Taur-Tech/Project-Ryu---Loudspeaker-Drivers/README.md

# Project-Ryu---Loudspeaker-Drivers
Design files for field coil loudspeaker drivers
