Taur-Tech/Project-Ryu---Loudspeaker-Drivers/Spreadsheets/Voice Coil Design.xlsx

Sheet: ECCAW
Wire Diameter: |  |  | 0.13 | mm |  |  |  | Cone Mass |  | 1
Density: |  |  | 3.7 | g/cm^3
Resistivity: |  |  | 0.0255 | ohm mm^2/m |  |  |  | VC Radius: | 25 | mm
Flux Density [B]: |  |  | 1.5 | T |  |  |  | Circ: | 157.0796327 | mm
Cross-sectional Area: |  |  | 0.000132665 | cm^2
 |  |  |  |  |  |  |  |  |  |  |  |  |  |  |  |  |  |  | 6mm Hvc
L wire | Mass | BL | DCR | VC h mm | Turns | DCR || | Mass || | noS/no|| |  |  |  |  |  |  |  | Zn | Len Wire | Rdc | Obs | BL | Mvc | BL^2/Rdc
1 | 0.05 | 1.5 | 1.92 | 0.8276057041 | 6.366197724 | 0.96 | 0.10 | 0.5233946729 |  | 0.5233946729 | 0.5080493055 | 0.5040573113 | 0.5027122104 | 0.5020369201 | 0.5016308648 | 16 | 7.33 | 14.09 | Single layer | 10.995 | 0.36 | 8.580303971
2 | 0.10 | 3 | 3.84 | 1.655211408 | 12.73239545 | 1.92 | 0.20 | 0.5446979576 |  | 0.5446979576 | 0.5158435518 | 0.5080493055 | 0.5053951551 | 0.5040573113 | 0.5032511253 | 8 | 7.33 | 7.04 | 2 Layer Parallel | 10.995 | 0.72 | 17.16060794
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
