Taur-Tech/Project-Ryu---Loudspeaker-Drivers/Drivers/F144/common/F144_driver_drawing.dxf

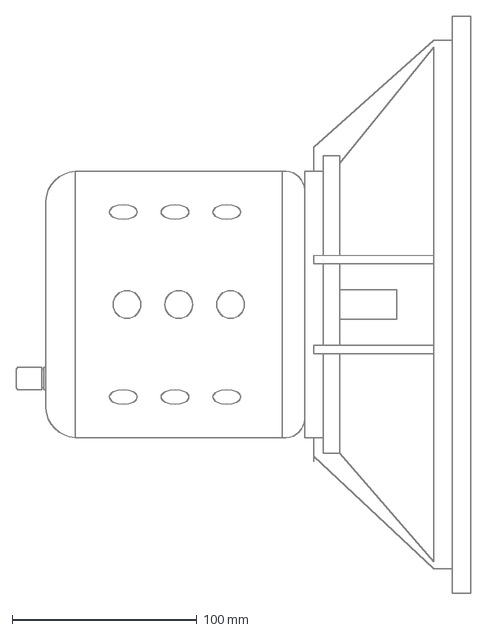
[picture p1: CAD file, 2017-06-22]
Drivers/F144/common/F144_driver_drawing.dxf
246.0 x 312.0 mm
