Taur-Tech/Project-Ryu---Loudspeaker-Drivers/Drivers/F144/motor/3D/step/F144_CP.step

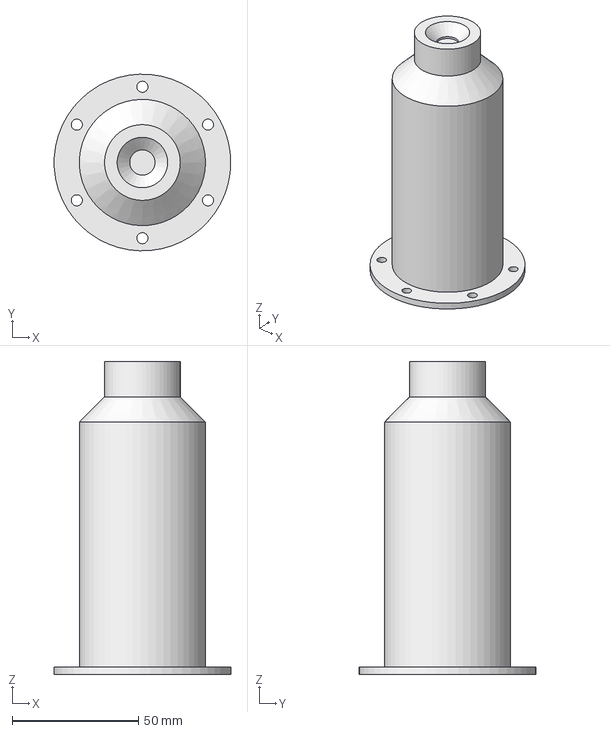
[picture p2: CAD file, 2017-01-30]
Drivers/F144/motor/3D/step/F144_CP.step
69.9 x 70.0 x 124.0 mm
