Taur-Tech/Project-Ryu---Loudspeaker-Drivers/Drivers/F144/motor/3D/stl/F144_FR2.stl

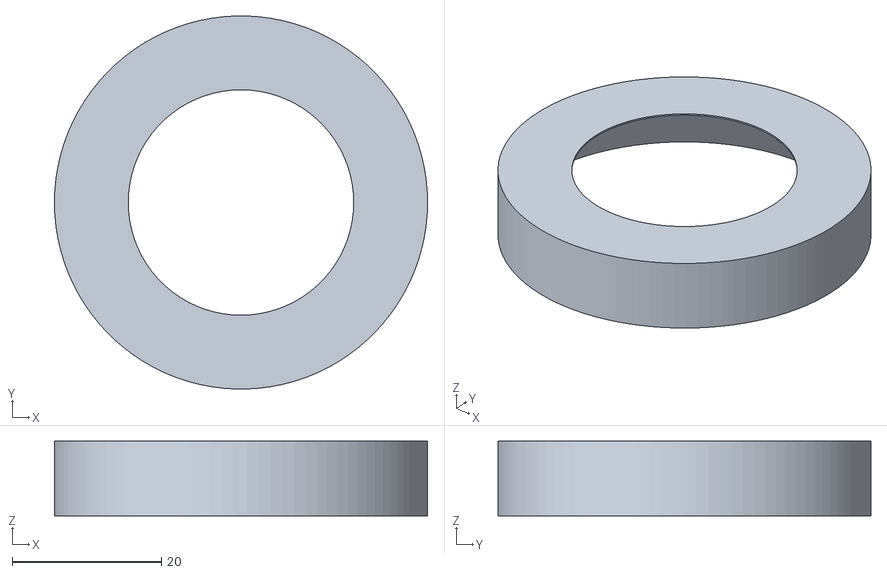
[picture p3: CAD file, 2017-05-06]
Drivers/F144/motor/3D/stl/F144_FR2.stl
50.0 x 50.0 x 10.0
