Taur-Tech/Project-Ryu---Loudspeaker-Drivers/Drivers/F144/motor/3D/step/F144_BP.step

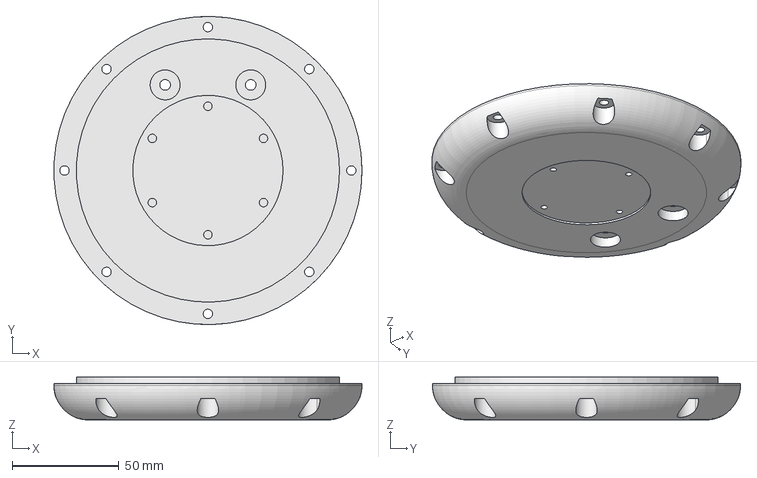
[picture p4: CAD file, 2017-01-30]
Drivers/F144/motor/3D/step/F144_BP.step
143.9 x 143.9 x 20.0 mm
