Taur-Tech/Project-Ryu---Loudspeaker-Drivers/Drivers/F144/motor/3D/step/F144_TP.step

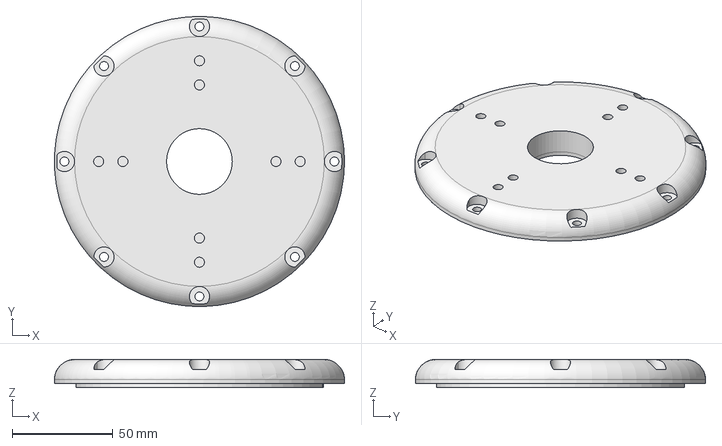
[picture p5: CAD file, 2017-01-30]
Drivers/F144/motor/3D/step/F144_TP.step
143.9 x 143.9 x 14.0 mm
