Taur-Tech/Project-Ryu---Loudspeaker-Drivers/(list of files, cad)

Other CAD files:
Drivers/F144/motor/3D/igs/F144_BP.iges
Drivers/F144/motor/3D/igs/F144_CP.iges
Drivers/F144/motor/3D/igs/F144_TP.iges
