Taur-Tech/Project-Ryu---Loudspeaker-Drivers/Drivers/F124/Project Ryu F124.pdf

1 | 2 | 3 | 4 | 5 | 6 | 7 | 8

64.00 mm

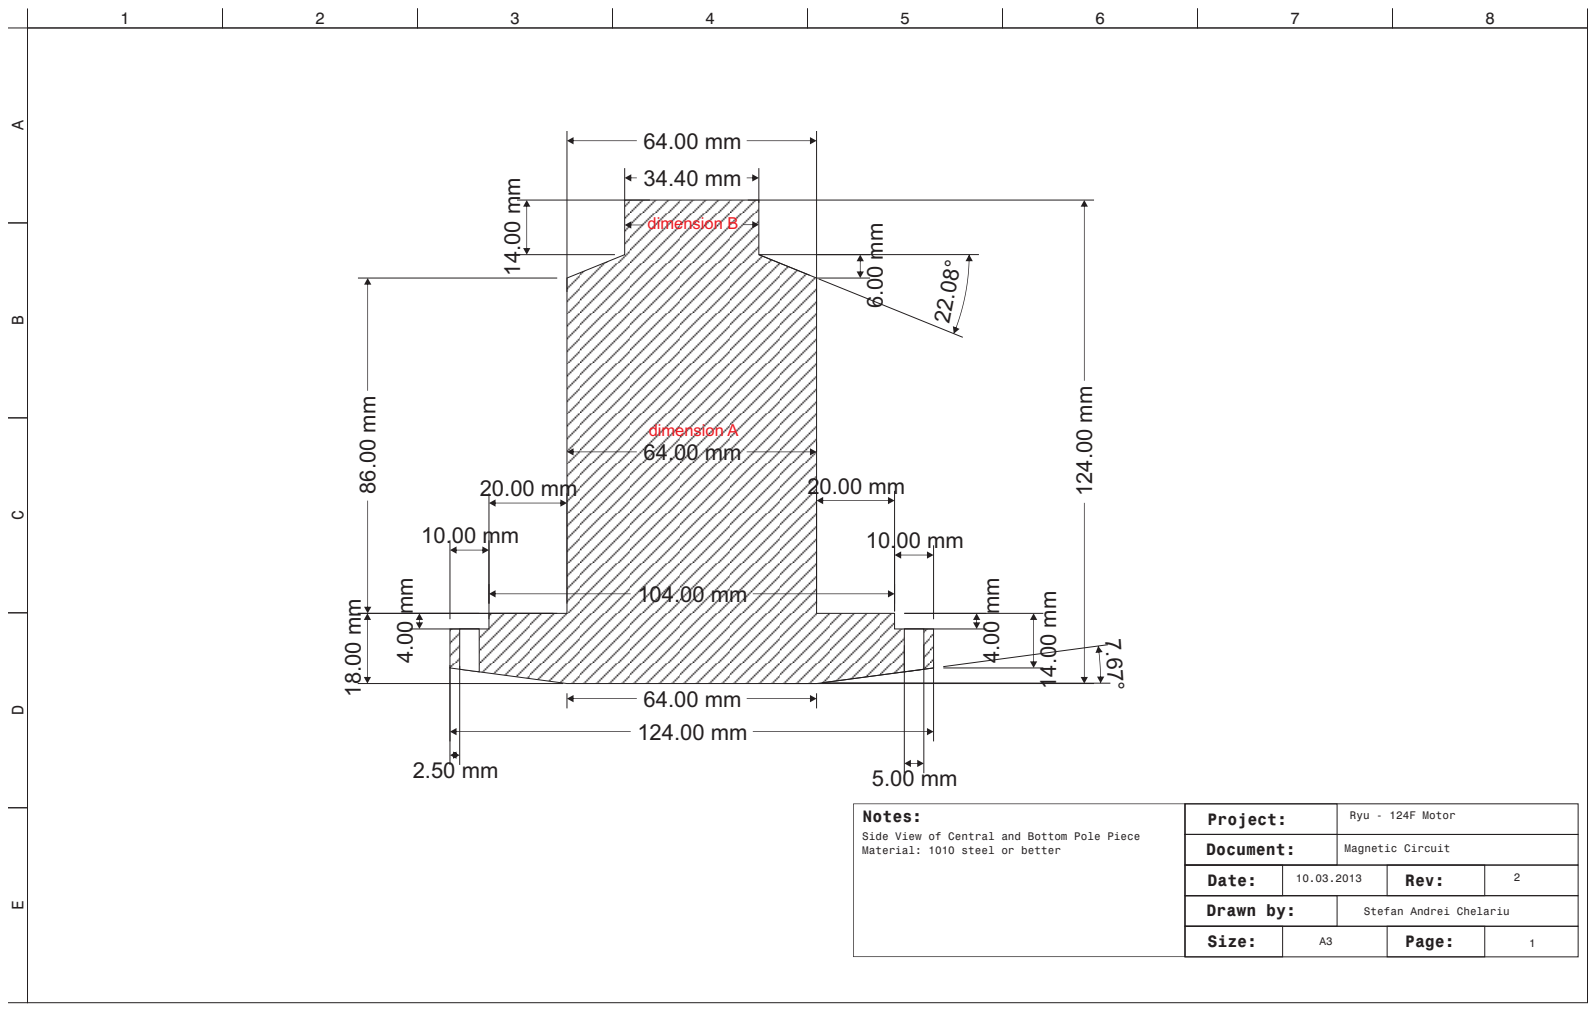
[picture p9: page 1]
Project:; Document:; Date:; Rev:; Drawn by:; Size:; Page:; Ryu - 124F Motor; Magnetic Circuit; Notes:; dimension A; dimension B

Side View of Central and Bottom Pole Piece
Material: 1010 steel or better

Stefan Andrei Chelariu

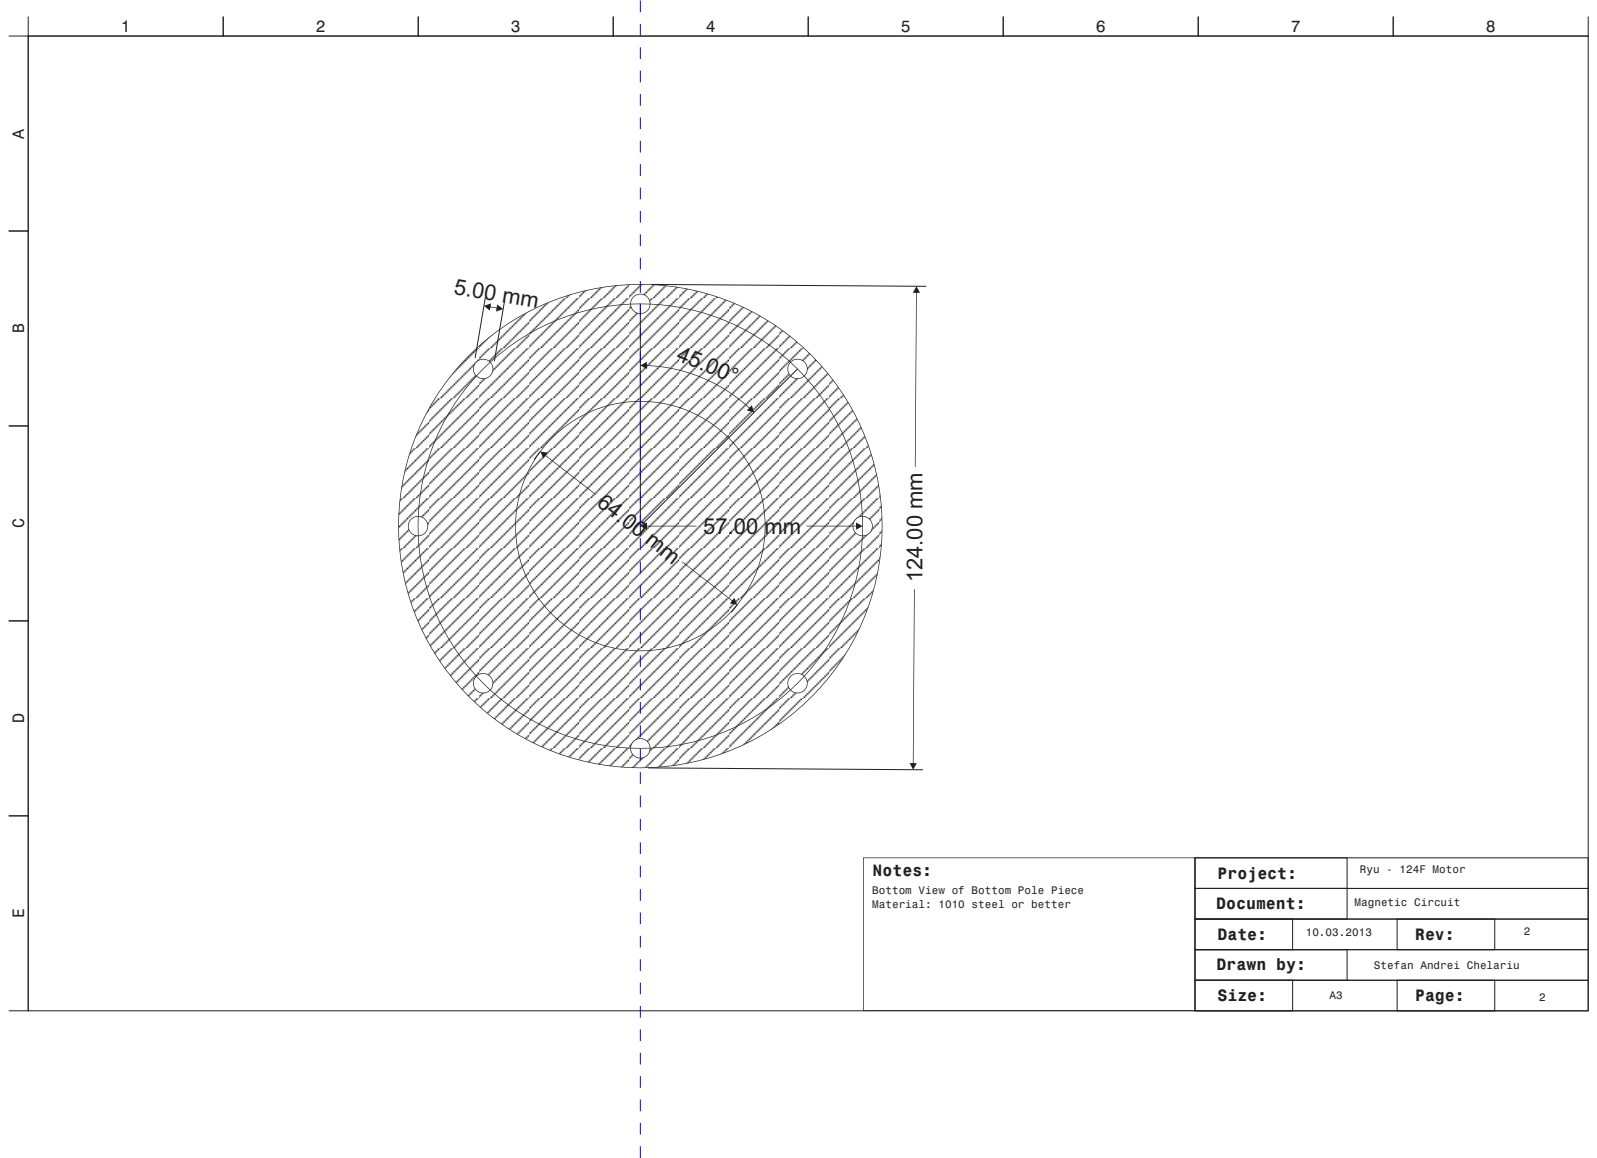
[picture p10: page 2]
Notes:

Project: | Ryu - 124F Motor

Bottom View of Bottom Pole Piece
Material: 1010 steel or better

Document: | Magnetic Circuit
Date: | 10.03.2013 | Rev: | 2
Drawn by: | Stefan Andrei Chelariu
Size: | A3 | Page: | 2

124.00 mm

37.40 mm

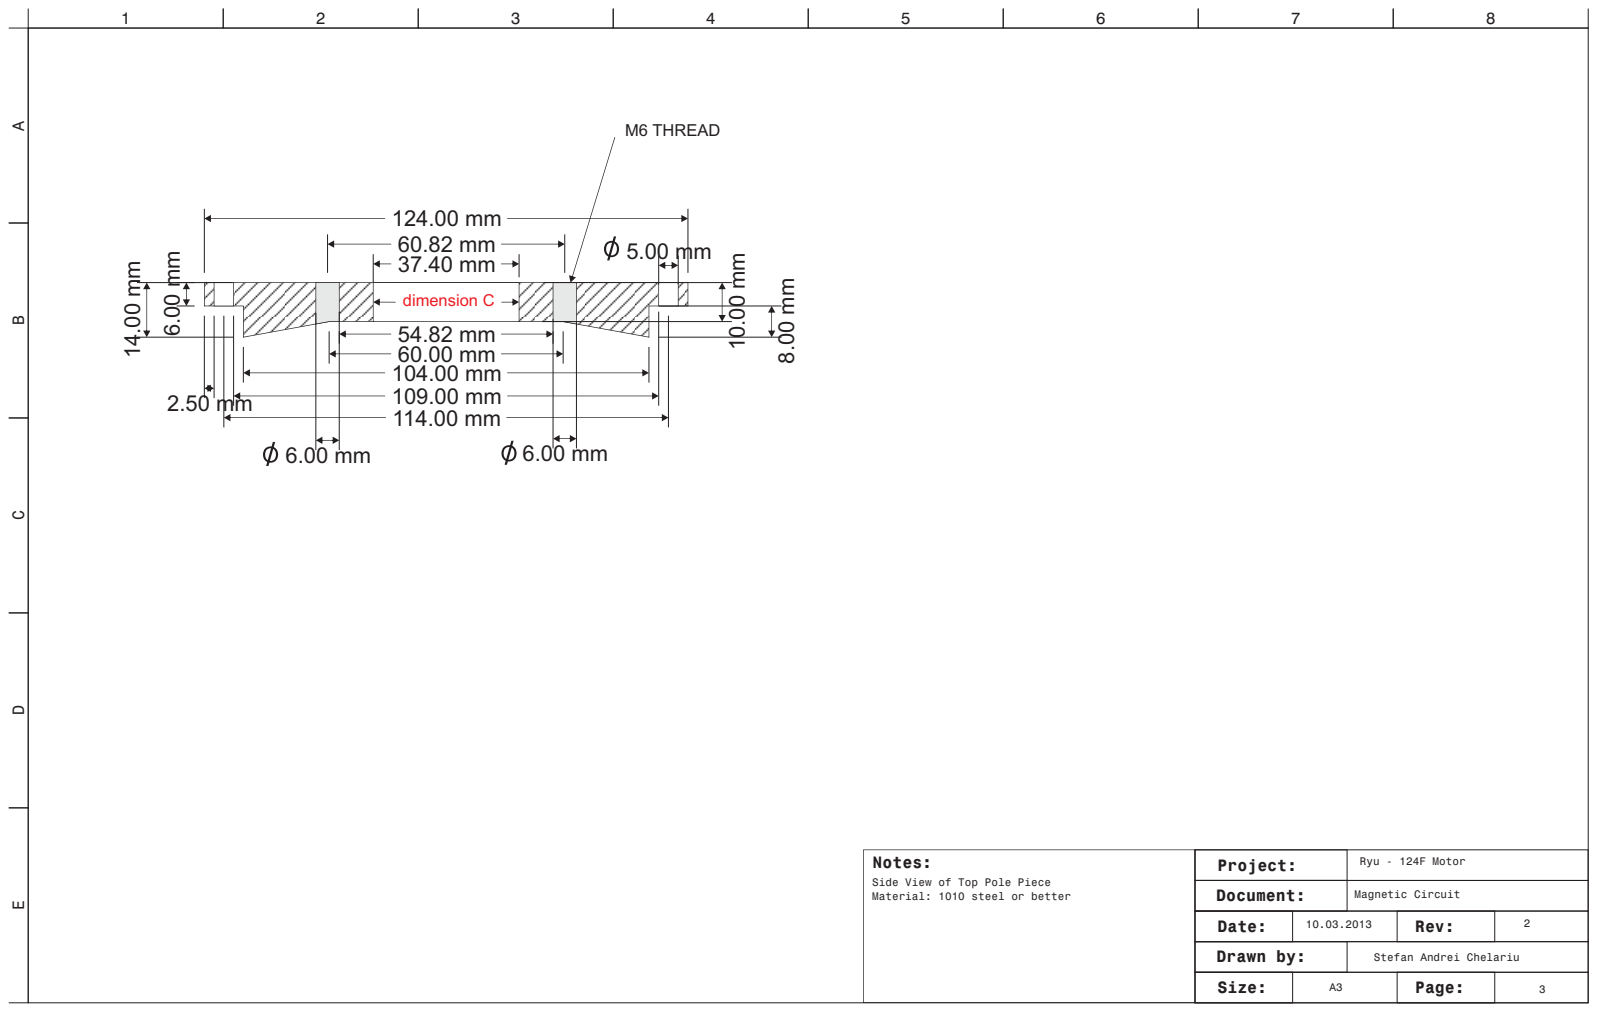
[picture p11: page 3]
Project:; Document:; Date:; Rev:; Drawn by:; Size:; Page:; Ryu - 124F Motor; Magnetic Circuit; Notes:; dimension C; M6 THREAD

Side View of Top Pole Piece
Material: 1010 steel or better

Stefan Andrei Chelariu

5.00 mm | 5.00 mm

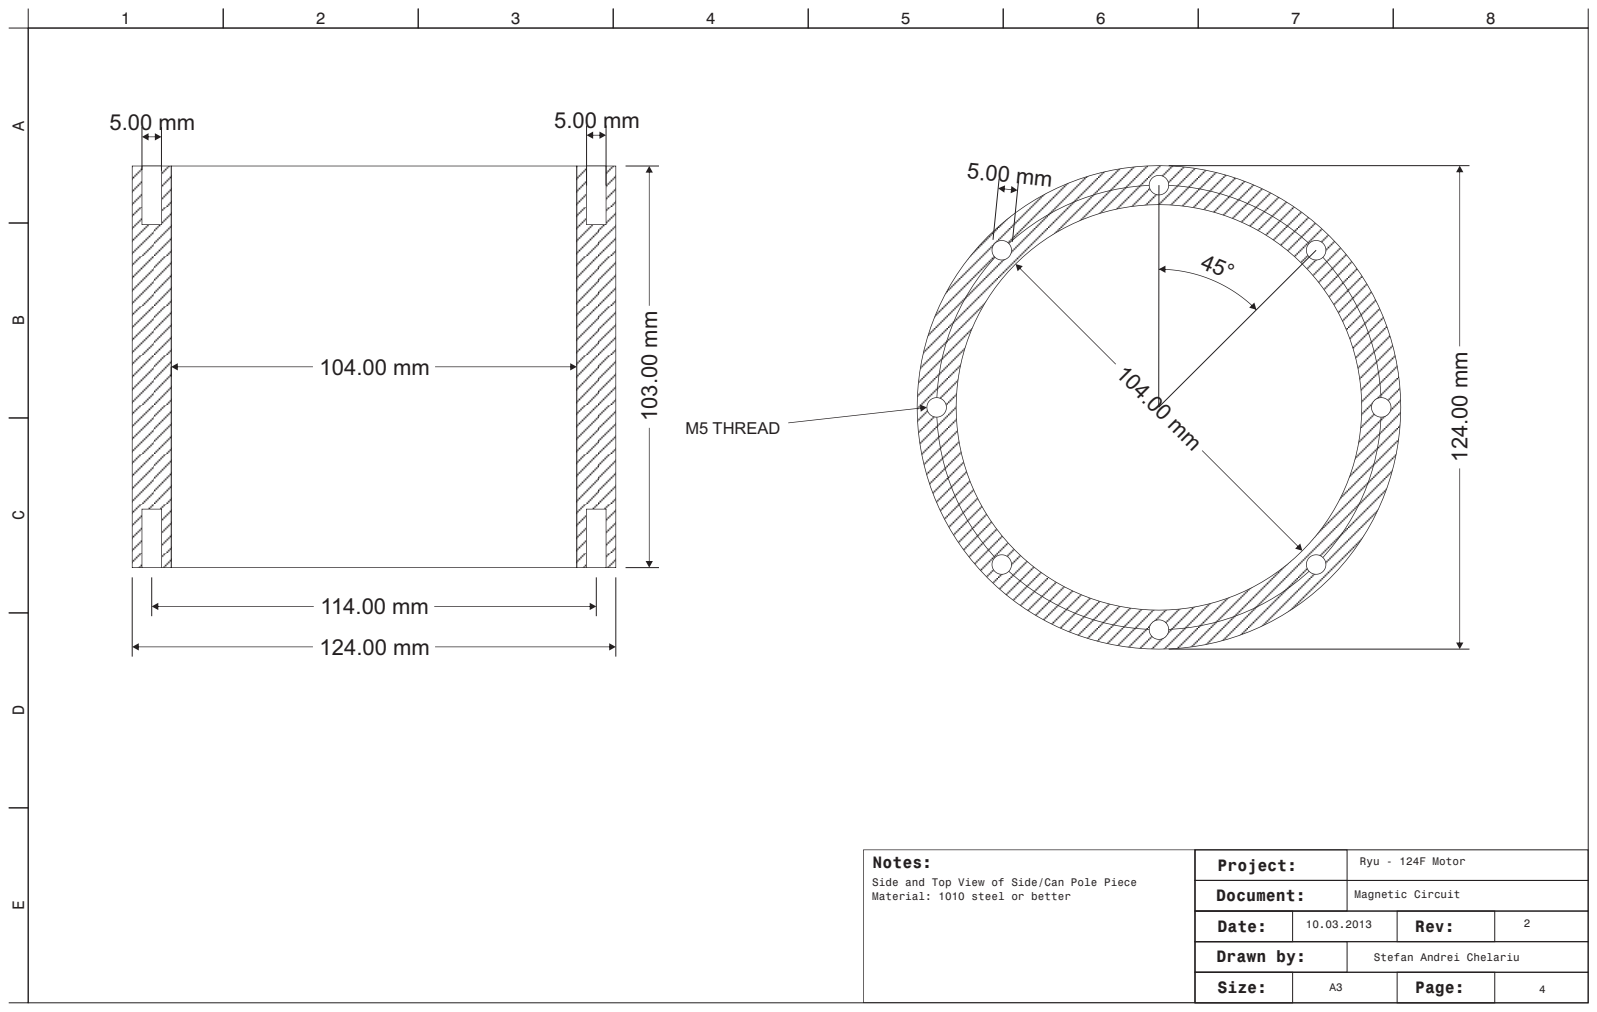
[picture p12: page 4]
Project:; Document:; Date:; Rev:; Drawn by:; Size:; Page:; Ryu - 124F Motor; Magnetic Circuit; Notes:; M5 THREAD

Side and Top View of Side/Can Pole Piece
Material: 1010 steel or better

Stefan Andrei Chelariu

5.00 mm

## M6 THREAD

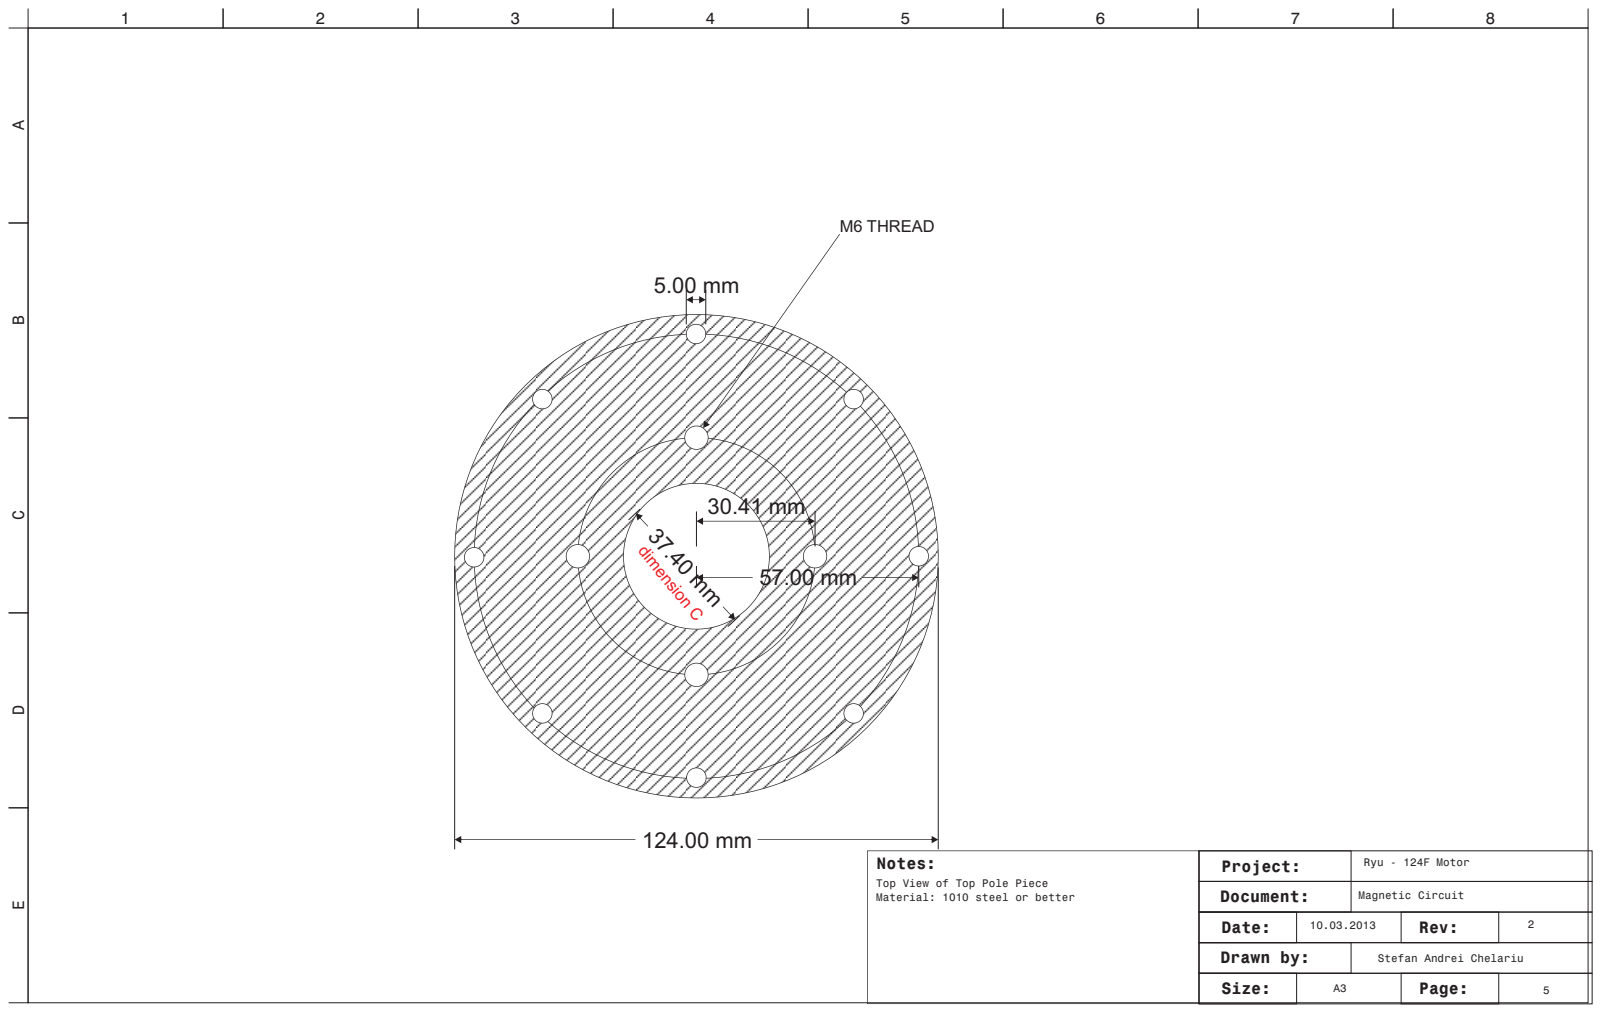
[picture p13: page 5]
Notes:; dimension C

Project: | Ryu - 124F Motor

Top View of Top Pole Piece
Material: 1010 steel or better

Document: | Magnetic Circuit
Date: | 10.03.2013 | Rev: | 2
Drawn by: | Stefan Andrei Chelariu
Size: | A3 | Page: | 5
