Taur-Tech/Project-Ryu---Loudspeaker-Drivers/Drivers/F160/Project Ryu F160 Drawing.pdf

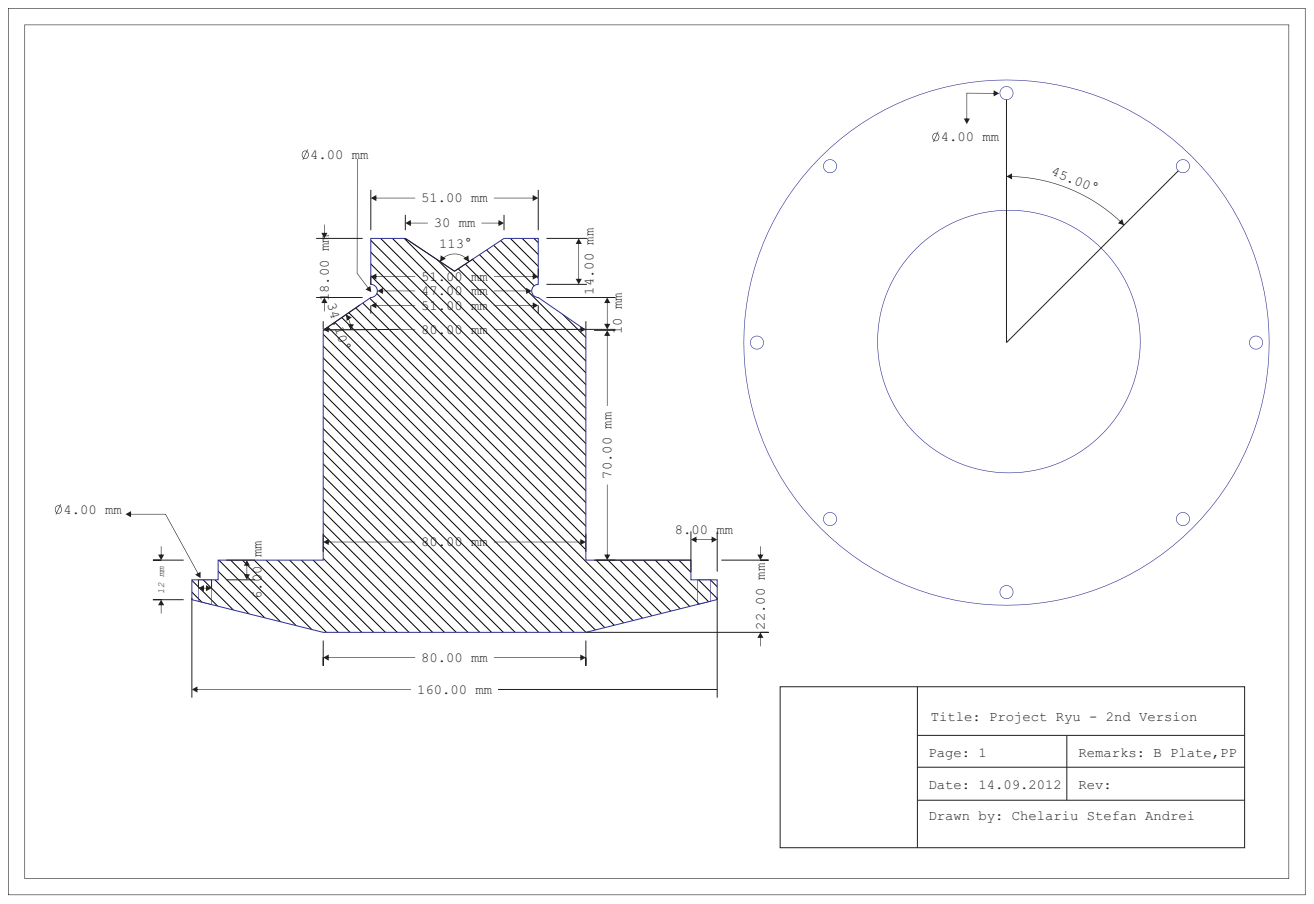
[picture p14: page 1]
Page: 1; Remarks: B Plate,PP; Date: 14.09.2012; Rev:

Title: Project Ryu - 2nd Version

Drawn by: Chelariu Stefan Andrei

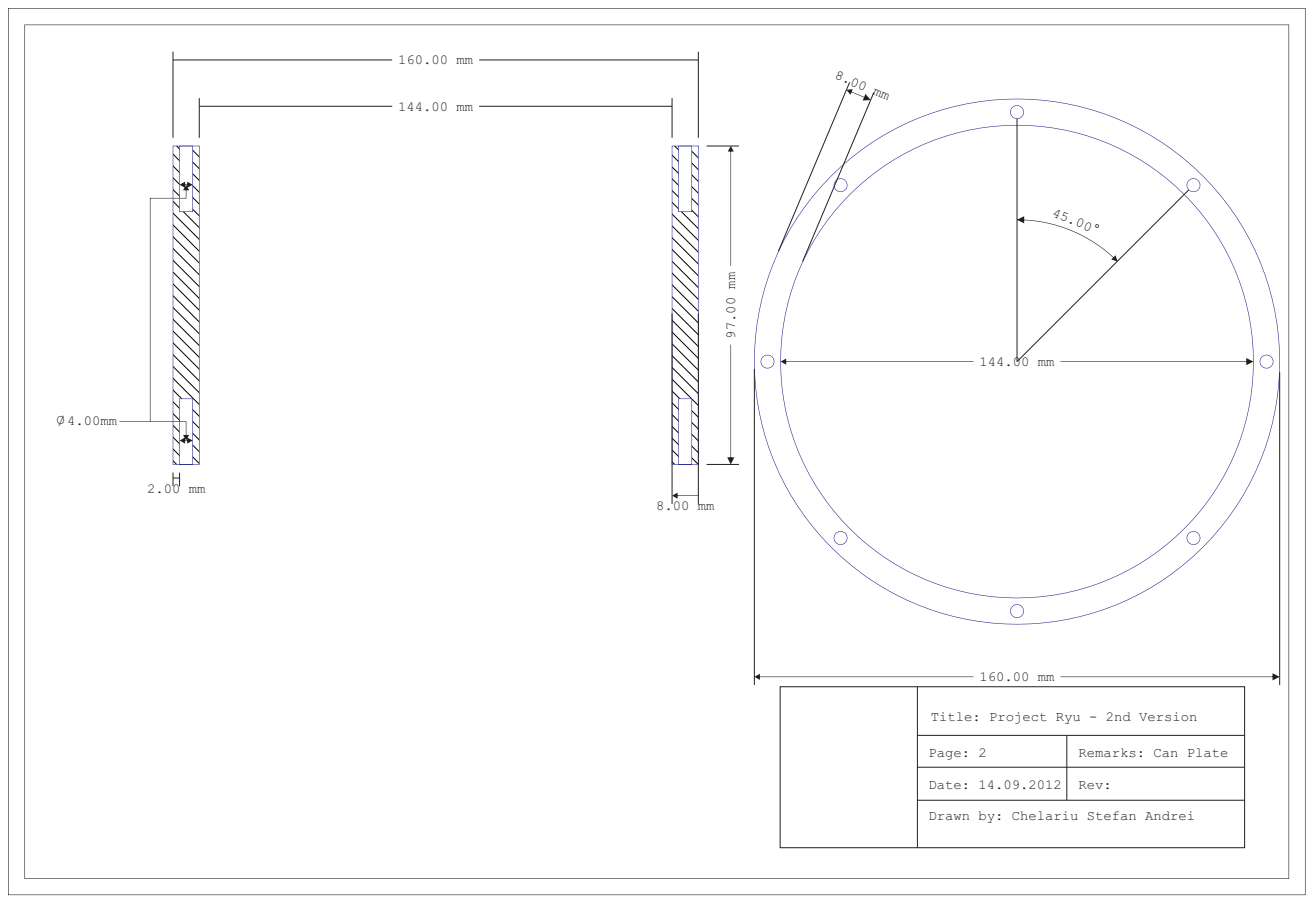
[picture p15: page 2]
Page: 2; Remarks: Can Plate; Date: 14.09.2012; Rev:

Title: Project Ryu - 2nd Version

Drawn by: Chelariu Stefan Andrei

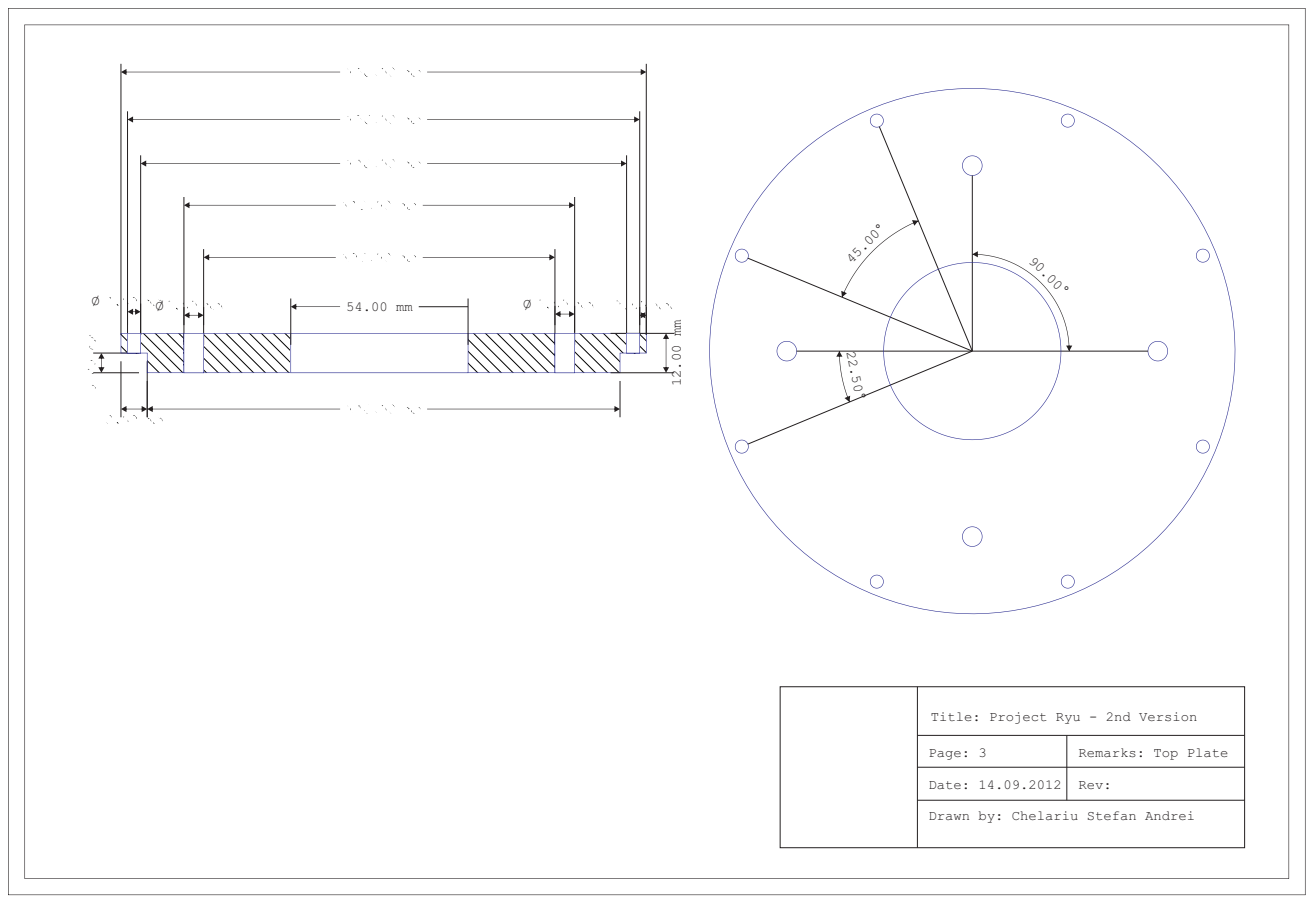
[picture p16: page 3]
Page: 3; Remarks: Top Plate; Date: 14.09.2012; Rev:

Title: Project Ryu - 2nd Version

Drawn by: Chelariu Stefan Andrei
