Taur-Tech/Project-Ryu---Loudspeaker-Drivers/Drivers/F144/motor/2D/F144_FR2.pdf

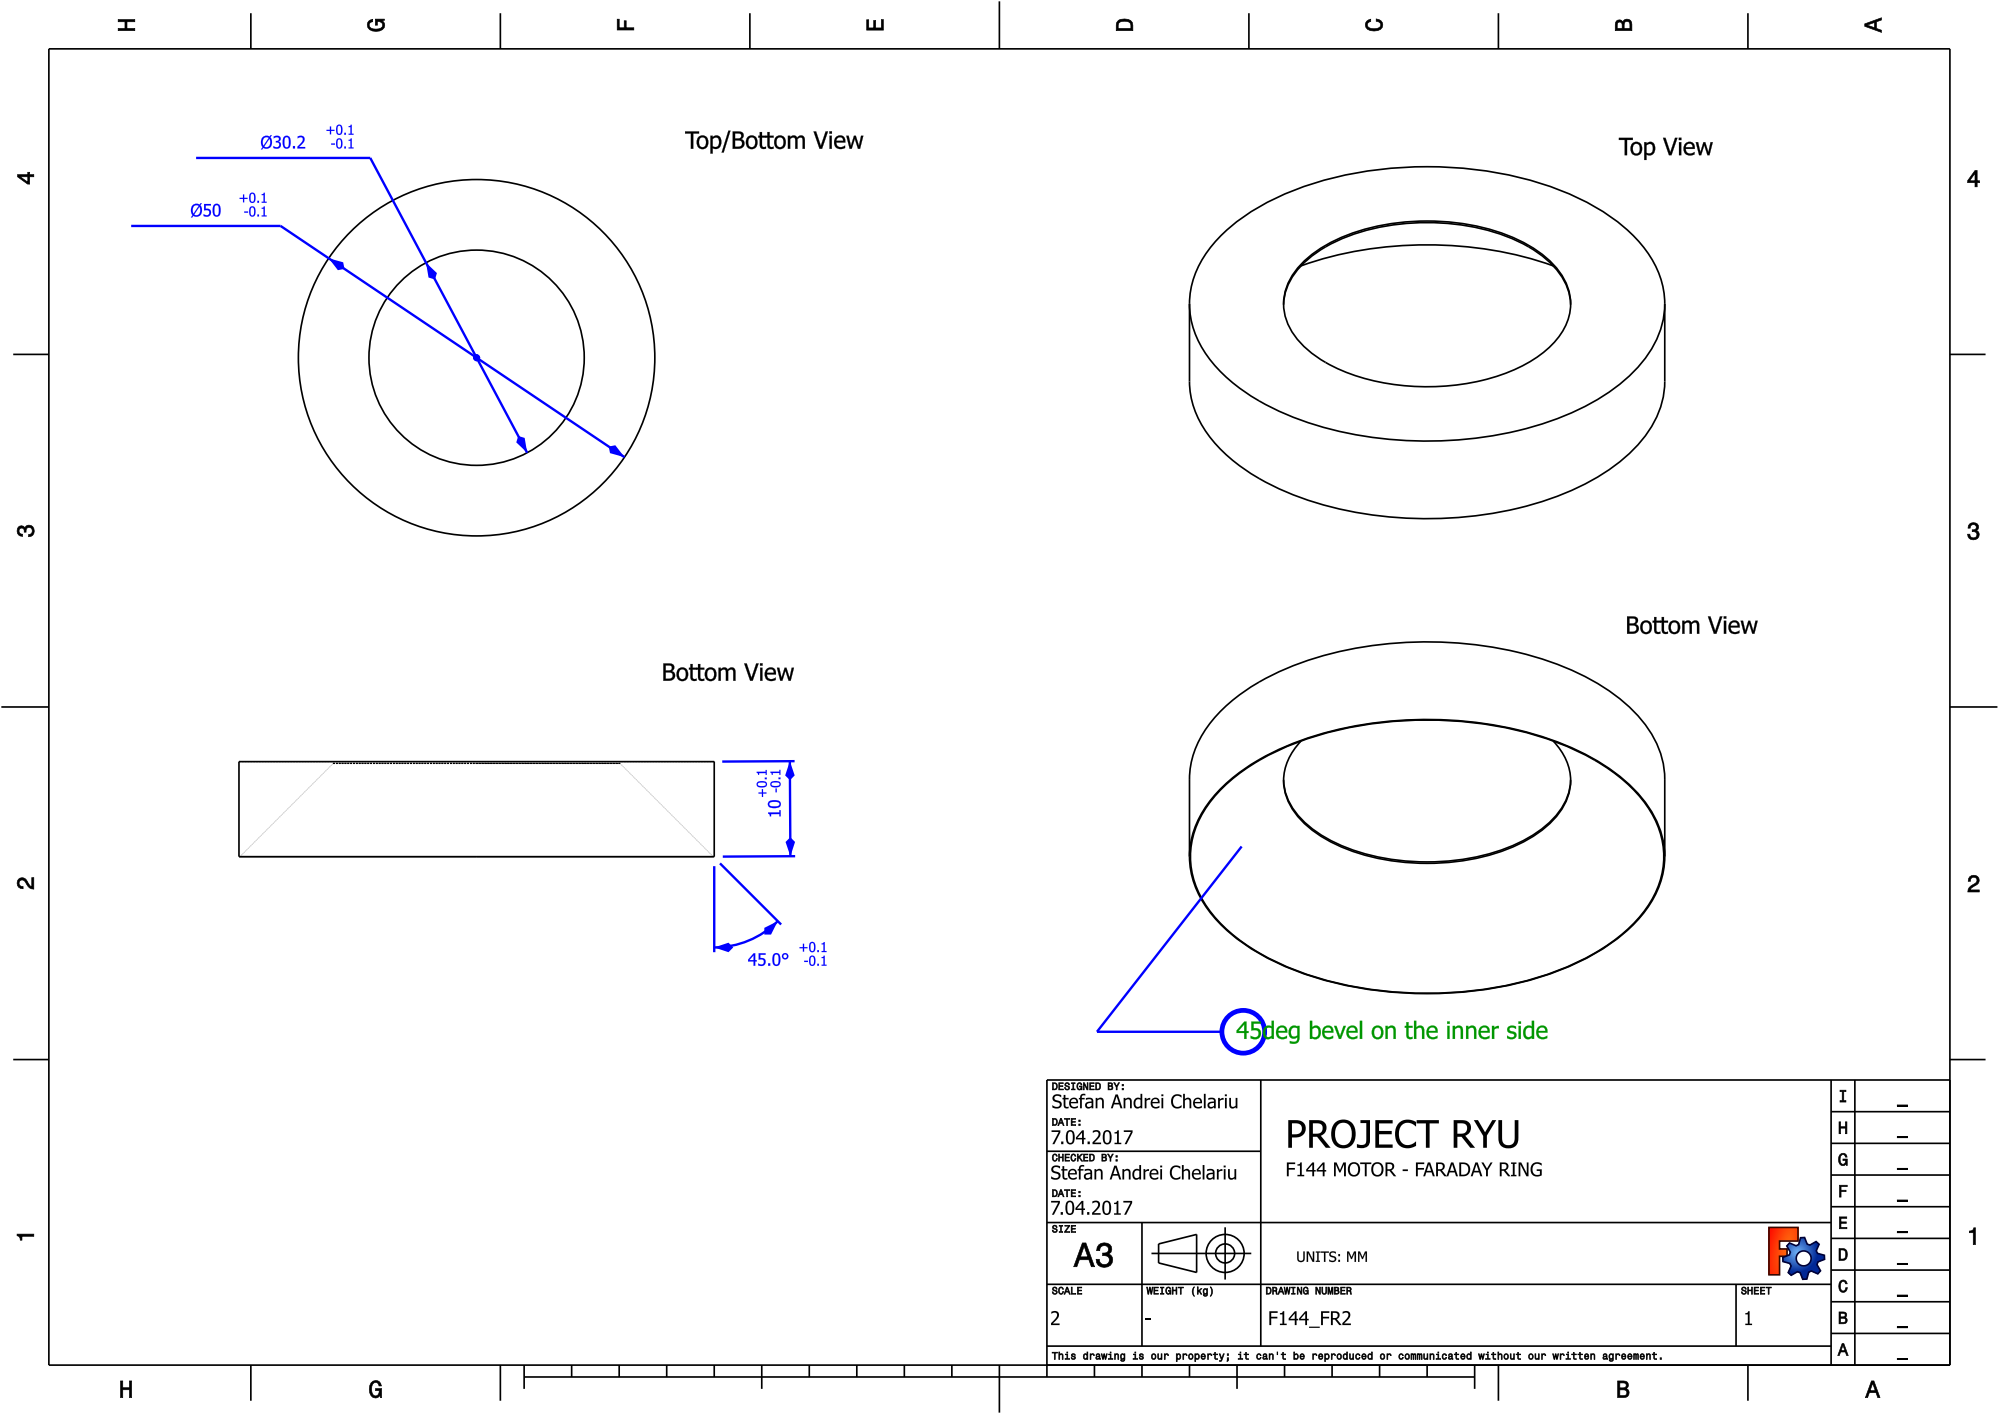
[picture p17: page 1]
