Taur-Tech/Project-Ryu---Loudspeaker-Drivers/Drivers/F144/motor/2D/F144_BP.pdf

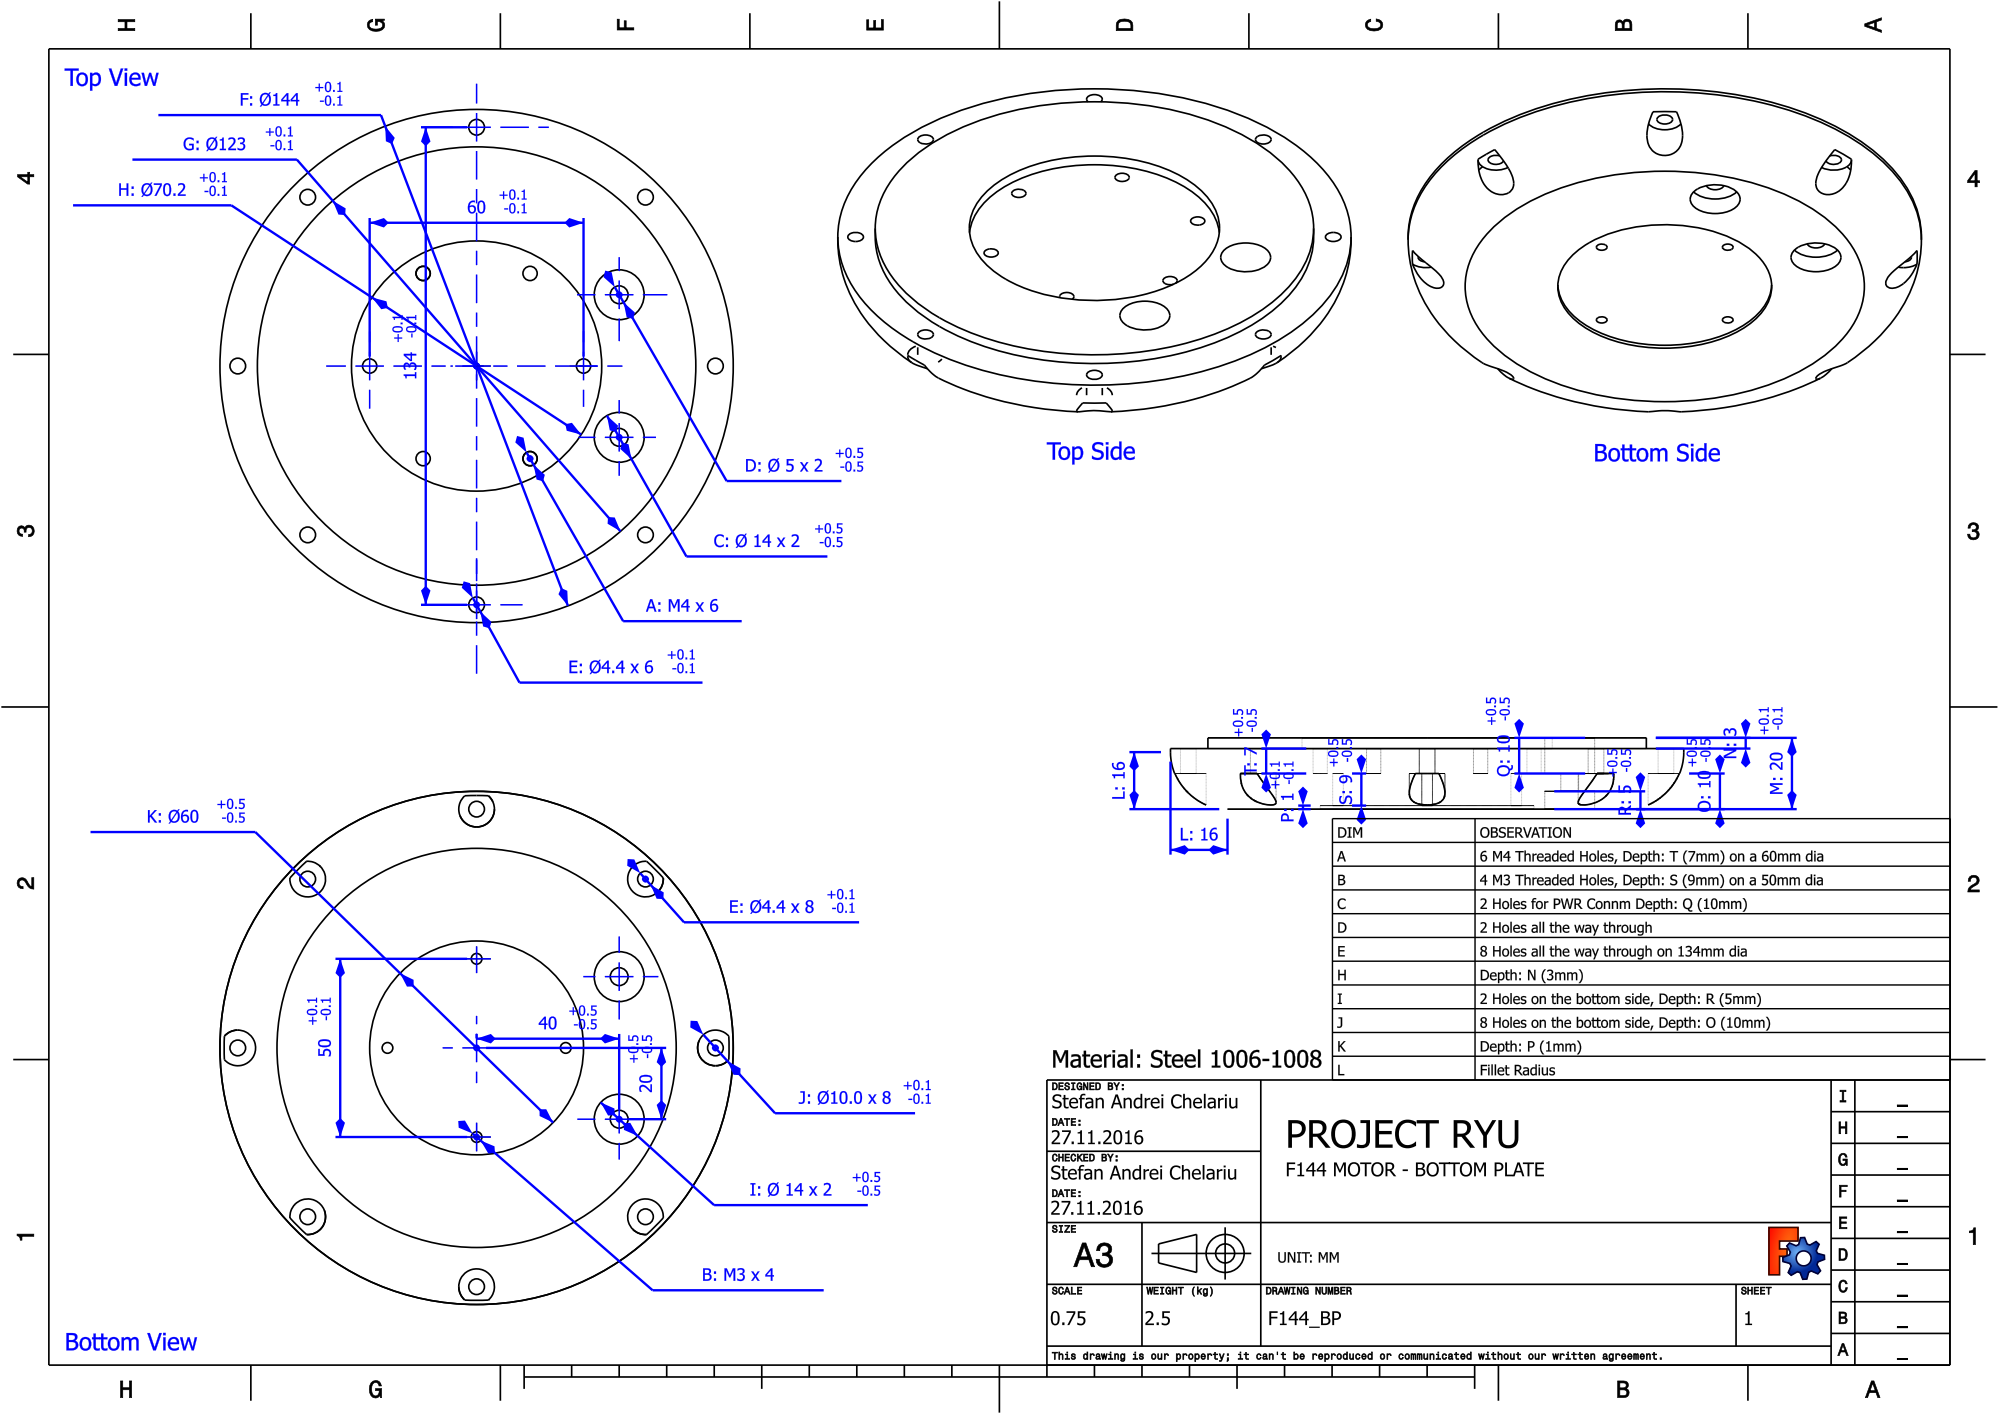
[picture p18: page 1]
