Taur-Tech/Project-Ryu---Loudspeaker-Drivers/Drivers/F144/motor/2D/F144_CP.pdf

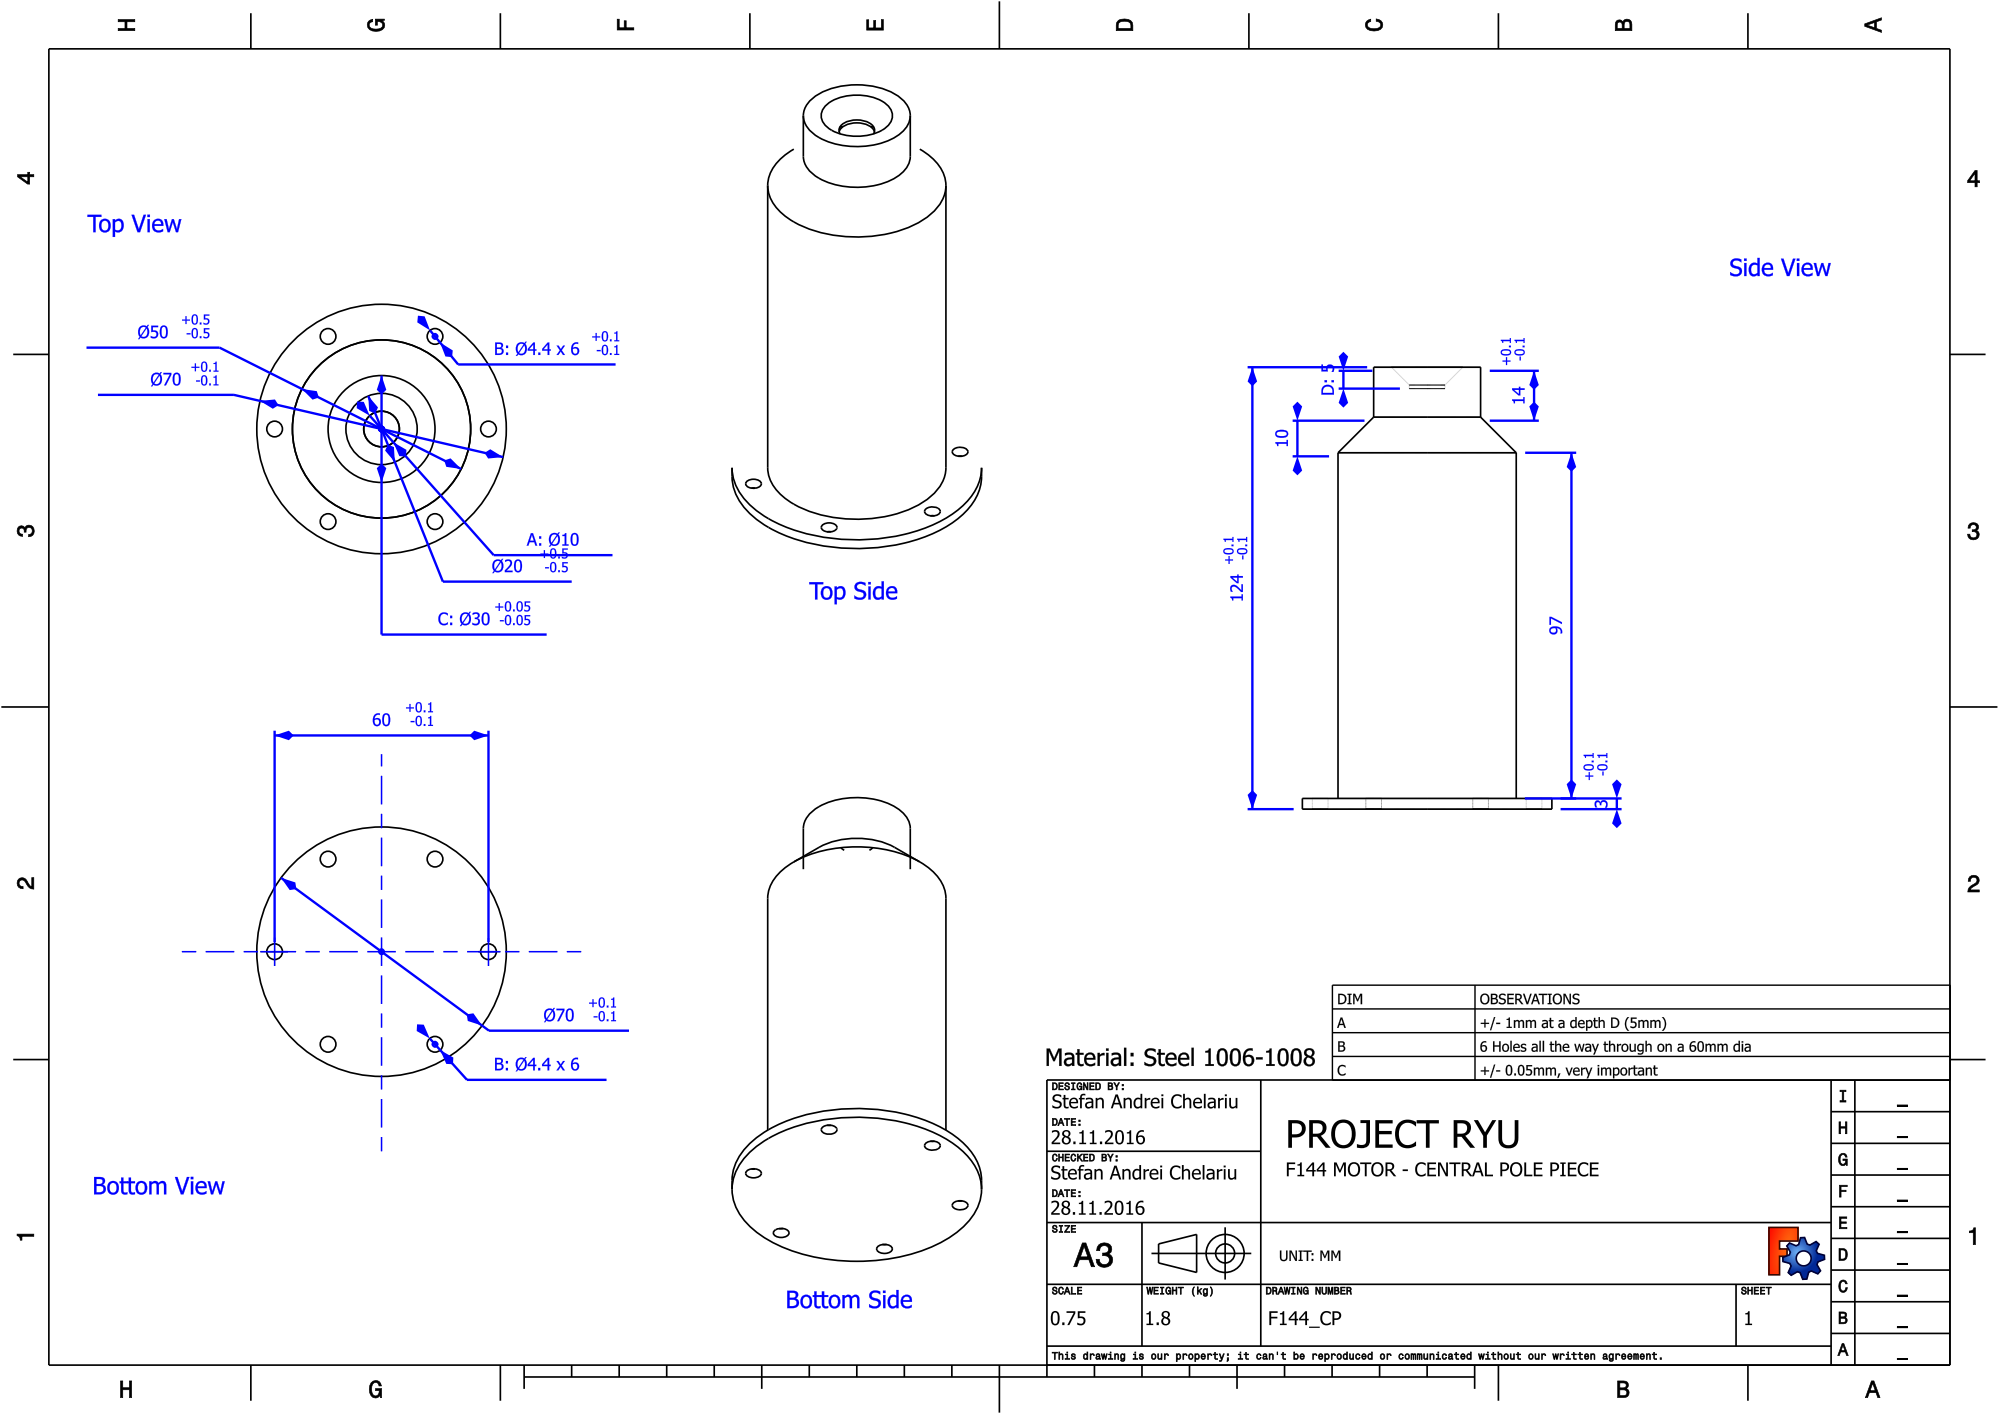
[picture p19: page 1]
