Taur-Tech/Project-Ryu---Loudspeaker-Drivers/Drivers/F144/motor/2D/F144_RP.pdf

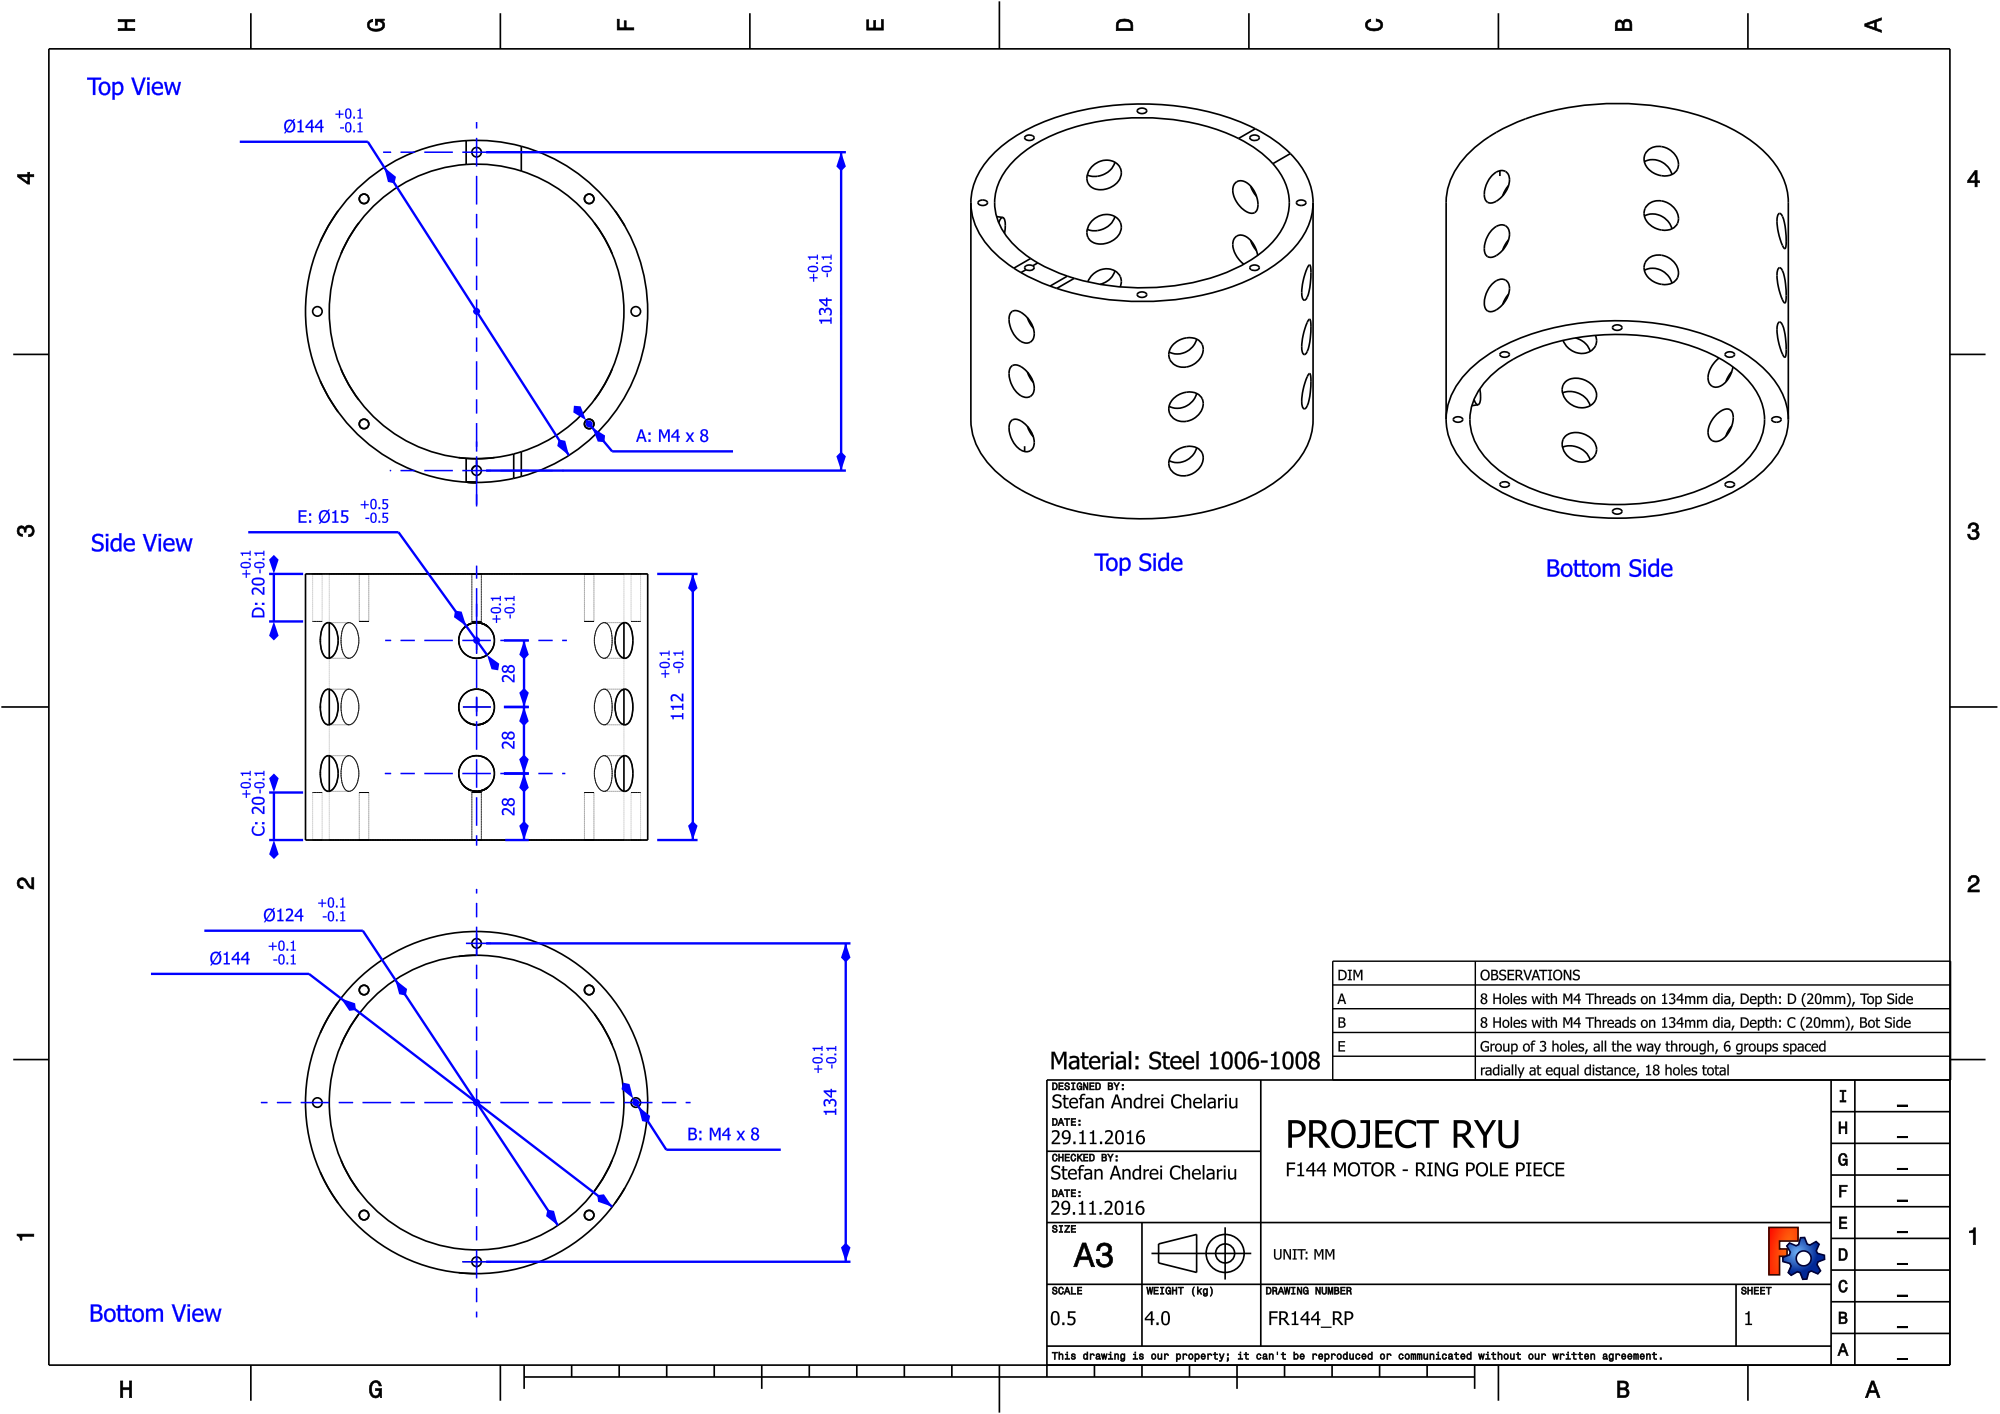
[picture p20: page 1]
