Taur-Tech/Project-Ryu---Loudspeaker-Drivers/Drivers/F144/motor/2D/F144_TP.pdf

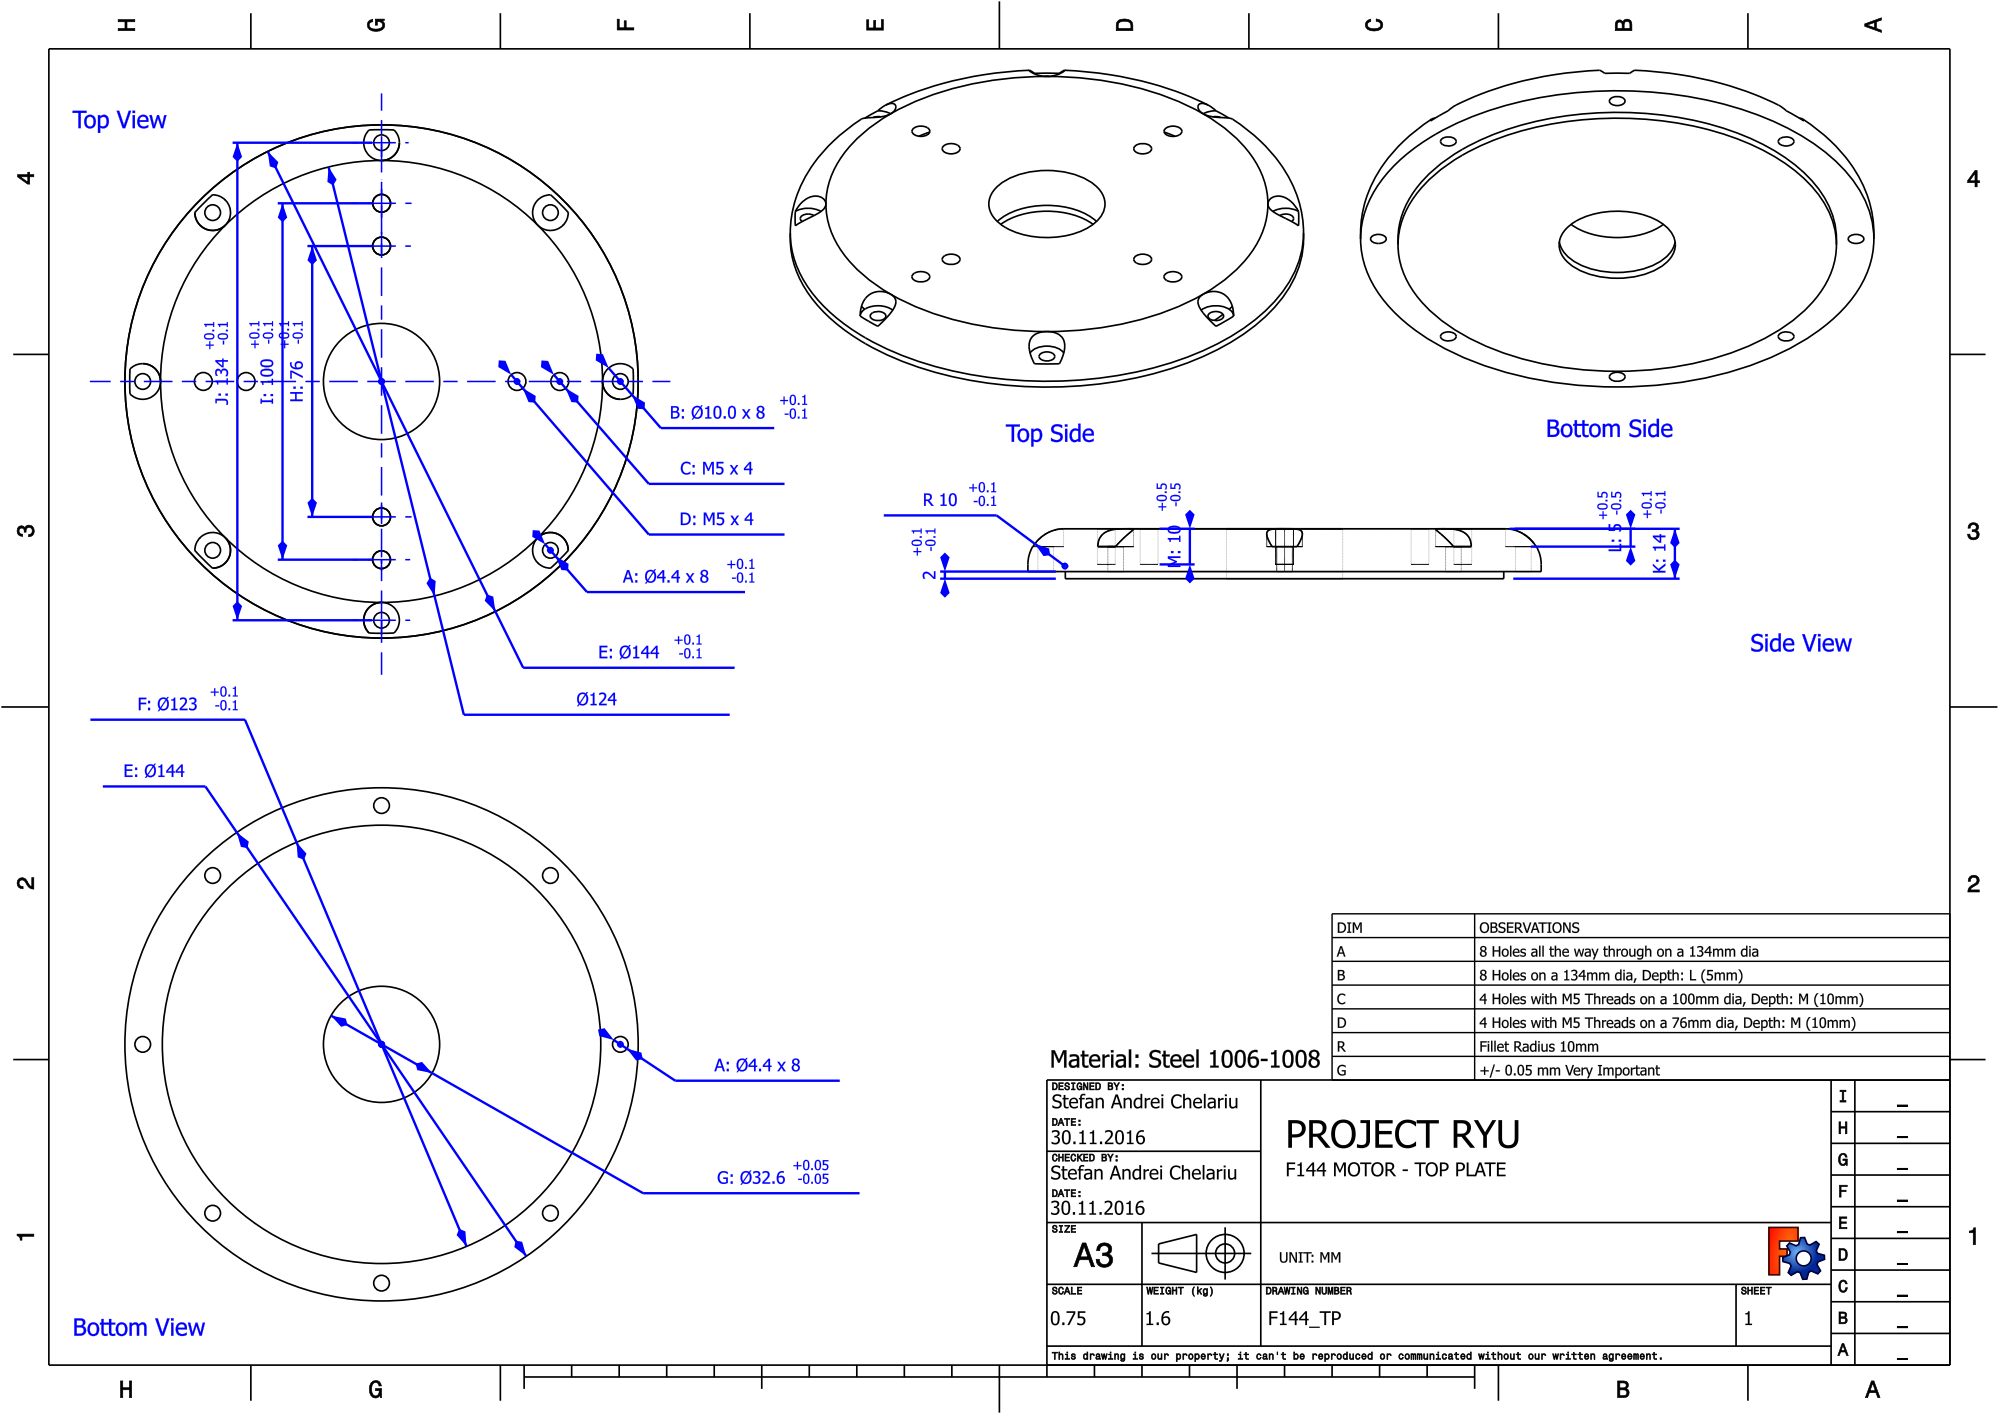
[picture p21: page 1]
