Taur-Tech/Project-Ryu---Loudspeaker-Drivers/Drivers/F144/models/F144W/voice coil/F144_VC403.pdf

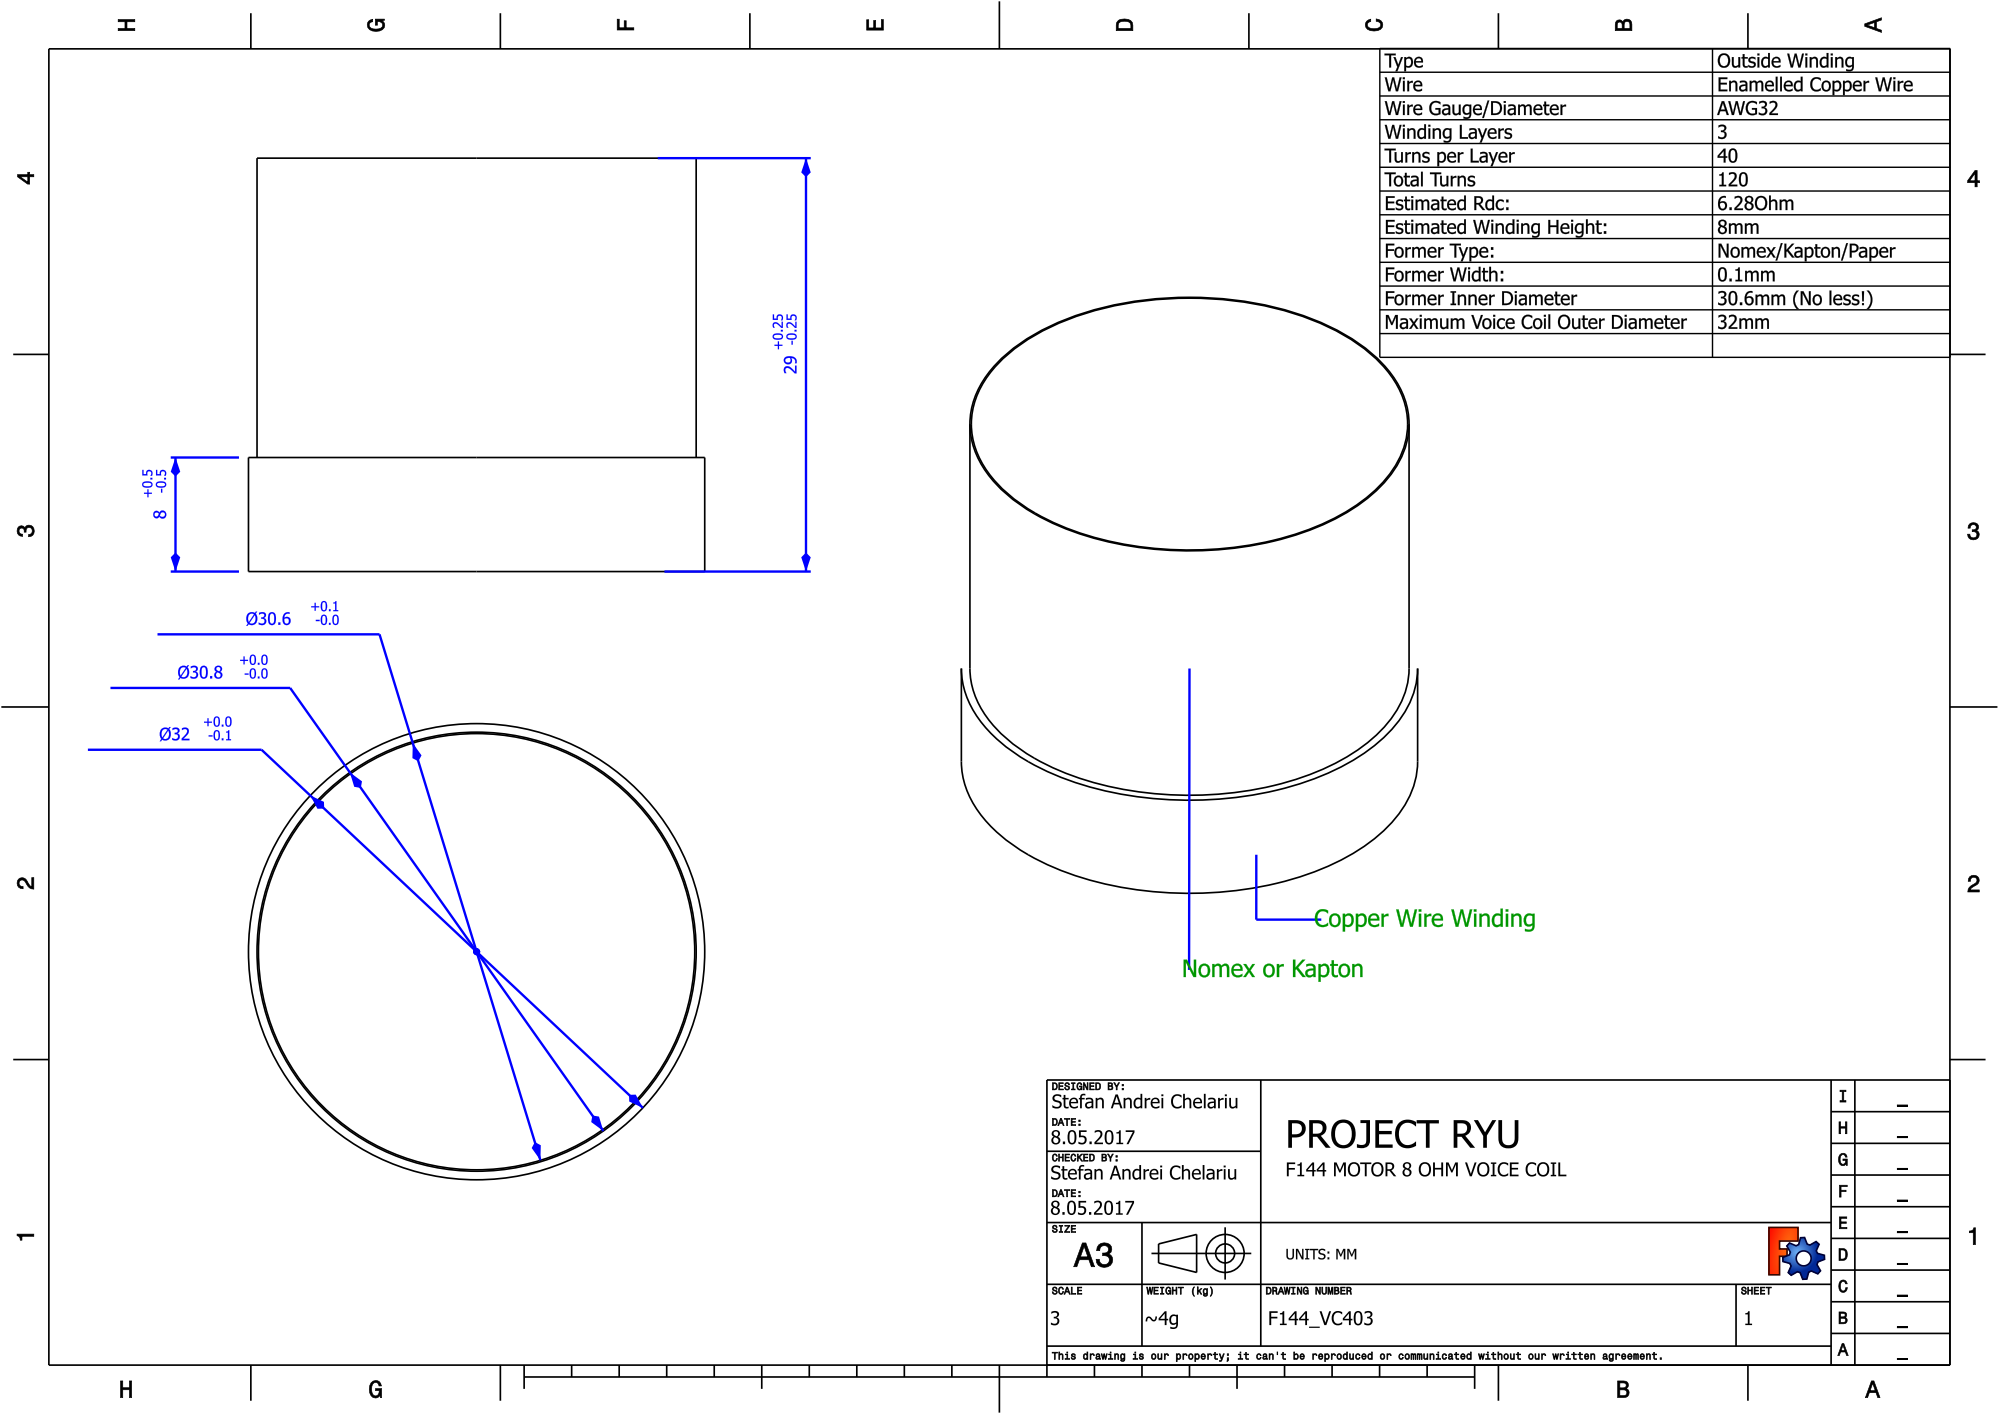
[picture p22: page 1]
