Taur-Tech/Project-Ryu---Loudspeaker-Drivers/(commit log)

2015-11-29 adding femm script for motors with ceramic 5 magnets
2015-11-29 added motor type at prompter
2016-05-19 added F124 plans; created F144 project
    [pryu_31mm_vc.scad]
2016-05-19 correct F144 voice coil turn number
    [pryu_31mm_vc.scad]
2017-01-30 added F144 motor parts 2D and 3D files
    [F144_BP.iges, F144_BP.step, F144_CP.iges, F144_CP.step, F144_TP.iges, F144_TP.step]
2017-05-06 F144 data + FEMM, mod description
    [F144_FR2.stl, pryu_31mm_vc.scad]
2017-06-22 adding F144W
    [F144_driver_drawing.dxf]
2019-03-26 Adding scilab script for compression driver impedance
